Normansrule/tinypulse-skywater130/docs/images/README.md

# Images

`layout.png` goes here: the KLayout render of the hardened GDSII.

It does not exist yet because place and route has not been run. See the
Layout section of the top-level README for how to produce and export it,
and `HARDENING.md` for the flow that produces the GDS in the first place.
