Normansrule/tinypulse-skywater130/sw/camera_sync.c

// camera_sync.c — what the chip is actually for.
//
// Fire a camera shutter at a fixed rate, timestamp the strobe return and an
// inertial measurement unit (IMU) data-ready line against the same clock,
// and report the offset between them. On a microcontroller the interrupt
// latency between those two events is tens of microseconds and it varies;
// here both are timestamped in hardware and the shutter edge is exact.

#include "tinypulse.h"
#include "tp_io.h"

#define FRAME_TICKS   500000u      // 100 Hz at 50 MHz
#define CH_STROBE     0u           // CAP0: camera strobe return
#define CH_IMU        1u           // CAP1: IMU data ready
#define TRIG_SHUTTER  0u           // TRIG0 -> camera trigger input

volatile uint32_t last_skew;
volatile uint32_t frames;

int main(void) {
    // capture CAP0 and CAP1 on their rising edges
    tp_cfg((1u << CH_STROBE) | (1u << CH_IMU));
    tp_pw(50);                          // 1 us shutter pulse at 50 MHz
    GPIO_SEL = 0xFF;                    // TRIG0 on uo_out[0], UART TX on uo_out[4]
    uart_puts("camera_sync: 100 Hz shutter on TRIG0, strobe on CAP0, IMU on CAP1\n");

    uint32_t next = tp_time() + FRAME_TICKS;

    for (;;) {
        // Arm the shutter for the exact tick, then park until just after it.
        // The pin edge does not depend on when this loop gets around to it.
        tp_arm(next, TRIG_SHUTTER);
        tp_wait(next + 2000);

        uint32_t strobe_ts = 0, imu_ts = 0;
        uint32_t got = 0;

        while (!TP_STAT_EMPTY(tp_stat())) {
            uint32_t e = tp_pop();
            if (TP_EVT_IS_SOFTWARE(e))
                continue;
            if (TP_EVT_CHANNEL(e) == CH_STROBE) {
                strobe_ts = TP_EVT_TIMESTAMP(e);
                got |= 1u;
            } else if (TP_EVT_CHANNEL(e) == CH_IMU) {
                imu_ts = TP_EVT_TIMESTAMP(e);
                got |= 2u;
            }
        }

        if (got == 3u)
            last_skew = (imu_ts - strobe_ts) & 0x07FFFFFFu;

        frames++;
        if (frames % 100u == 0u) {          // once a second: report over the UART
            uart_puts("frame "); uart_putu(frames);
            uart_puts(got == 3u ? "  IMU-strobe skew " : "  (no strobe/IMU edges seen)");
            if (got == 3u) { uart_putu(last_skew * 20u); uart_puts(" ns"); }
            uart_putc('\n');
        }
        next += FRAME_TICKS;
    }
}
