Normansrule/tinypulse-skywater130/src/sync/sync_compare.sv

// sync_compare.sv — deadline -> trigger pulse, with zero software in the path.
//
// Arm a channel with an absolute timebase value. When the timebase reaches
// it, the output pin goes high for PW ticks and the channel disarms. The
// output edge lands on the exact clock the deadline is met, so the jitter
// between the programmed time and the pin edge is zero, not "one interrupt
// latency". That is the number that matters when this fires a camera shutter
// or a laser-scanner sync line.
//
// The comparison is a signed difference so an armed deadline survives the
// timebase rolling over.
`default_nettype none

module sync_compare #(
    parameter int NCMP = 2,
    parameter int PWW  = 16
) (
    input  wire  logic             clk,
    input  wire  logic             rst,
    input  wire  logic [31:0]      now,
    // arm: one-hot-ish write of a deadline into channel `sel`
    input  wire  logic             arm_we,
    input  wire  logic [31:0]      arm_time,
    input  wire  logic [1:0]       arm_sel,
    // direct fire, bypassing the deadline compare
    input  wire  logic             pulse_we,
    input  wire  logic [NCMP-1:0]  pulse_mask,
    // pulse width in ticks
    input  wire  logic             pw_we,
    input  wire  logic [31:0]      pw_in,
    output logic [NCMP-1:0]        trig,
    output logic [NCMP-1:0]        armed
);

    logic [PWW-1:0] pw;
    logic [31:0]    deadline [NCMP-1:0];
    logic [PWW-1:0] pulse_cnt [NCMP-1:0];

    genvar i;
    generate
    for (i = 0; i < NCMP; i = i + 1) begin : g_cmp

        logic reached, fire;

        // Fire one tick early, because the trigger output is registered:
        // that makes the pin edge land on exactly the tick that was
        // programmed instead of one after it.
        //
        // This looks like it costs a second 32-bit adder per channel, and
        // an earlier version rewrote it as `now - deadline >= -1` to avoid
        // that. Measured, the rewrite was WORSE: synthesis already shares
        // the single `now + 1` incrementer across every channel, while the
        // rewrite needs a 32-input AND tree in each one. It cost about
        // 1,000 um^2 across three channels. Left as written.
        assign reached = ($signed((now + 32'd1) - deadline[i]) >= 0);
        assign fire    = (armed[i] && reached) ||
                         (pulse_we && pulse_mask[i]);

        always_ff @(posedge clk) begin
            if (rst) begin
                armed[i]     <= 1'b0;
                deadline[i]  <= 32'd0;
                pulse_cnt[i] <= '0;
            end else begin
                if (arm_we && (arm_sel == i[1:0])) begin
                    deadline[i] <= arm_time;
                    armed[i]    <= 1'b1;
                end else if (armed[i] && reached) begin
                    armed[i]    <= 1'b0;
                end

                if (fire)                        pulse_cnt[i] <= pw;
                else if (pulse_cnt[i] != '0)     pulse_cnt[i] <= pulse_cnt[i] - 1'b1;
            end
        end

        assign trig[i] = (pulse_cnt[i] != '0);
    end
    endgenerate

    always_ff @(posedge clk) begin
        if (rst)        pw <= {{(PWW-4){1'b0}}, 4'd8};   // 8 ticks by default
        else if (pw_we) pw <= pw_in[PWW-1:0];
    end

    wire _unused = &{1'b0, pw_in[31:PWW], 1'b0};

endmodule : sync_compare
