Normansrule/tinypulse-skywater130/(commit log)

2026-09-25 Measured 69,866 um^2 on sky130: tiles 2x2 -> 4x2
    Drop file-scope import for tp_pkg::NAME — Yosys 0.52 rejects the import
    form depending on read order. Removes the IMPORTSTAR waiver. Adds
    tb_xpulse, VERIFICATION.md, syn/area_sky130.sh.
2026-10-02 C toolchain, official RISC-V tests, demo-board bridge, printf/SPI, visuals
